nguyenphilanh3706-a11y/Design-and-Implementation-Smart-Indoor-Environment-Monitoring-and-Climate-Control-System/Hardware/Electrical_Circuit/AHT20_module.webp

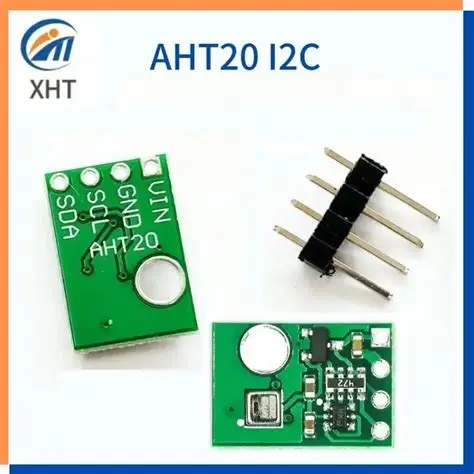
Hardware/Electrical_Circuit/AHT20_module.webp
