nguyenphilanh3706-a11y/Design-and-Implementation-Smart-Indoor-Environment-Monitoring-and-Climate-Control-System/Hardware/Electrical_Circuit/Pin_Mapping.md

# Pin Mapping

## Wiring Diagram

| Component  | Pin | ESP32 GPIO |
| --- | --- | --- |
| MQ-135 | D0  | GPIO 27 |
| | A0  | GPIO 34 |
| AHT20 | SDA | GPIO 21 (I2C) |
| | SCL | GPIO 22 (I2C) |
| LCD | SDA | GPIO 21 (I2C) |
| | SCL | GPIO 22 (I2C) |
| Buzzer | + | GPIO 23 |
| Fan MOSFET | PWM | GPIO 27 |
