nguyenphilanh3706-a11y/Design-and-Implementation-Smart-Indoor-Environment-Monitoring-and-Climate-Control-System/Hardware/Electrical_Circuit/MQ135_module.webp

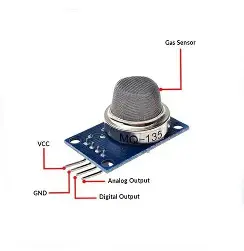
Hardware/Electrical_Circuit/MQ135_module.webp
