nguyenphilanh3706-a11y/Design-and-Implementation-Smart-Indoor-Environment-Monitoring-and-Climate-Control-System/(commit log)

2026-09-18 Hieu chuan sensor MQ135
2026-09-29 Fix code hieu chuan MQ135
    [HieuChuanMQ135.ino]
